IngenieroMecatronico/Firefighter/Firefighter_Plataforma/README.txt

OmniBotCC TRUE CLONE V3

Final refinements:
- PID gains matched to ESP-IDF firmware
- Static IP support added
- Full UDP compatibility
- Hardware mapping verified from schematic

Static IP:
192.168.50.171

UDP Commands:
start
stop
m0_rpm=150
m1_rpm=-120
m2_rpm=100
m3_rpm=-80
m0_dir=CW
m0_dir=CCW
