IngenieroMecatronico/Firefighter/STLs/Soporte_tambito.stl

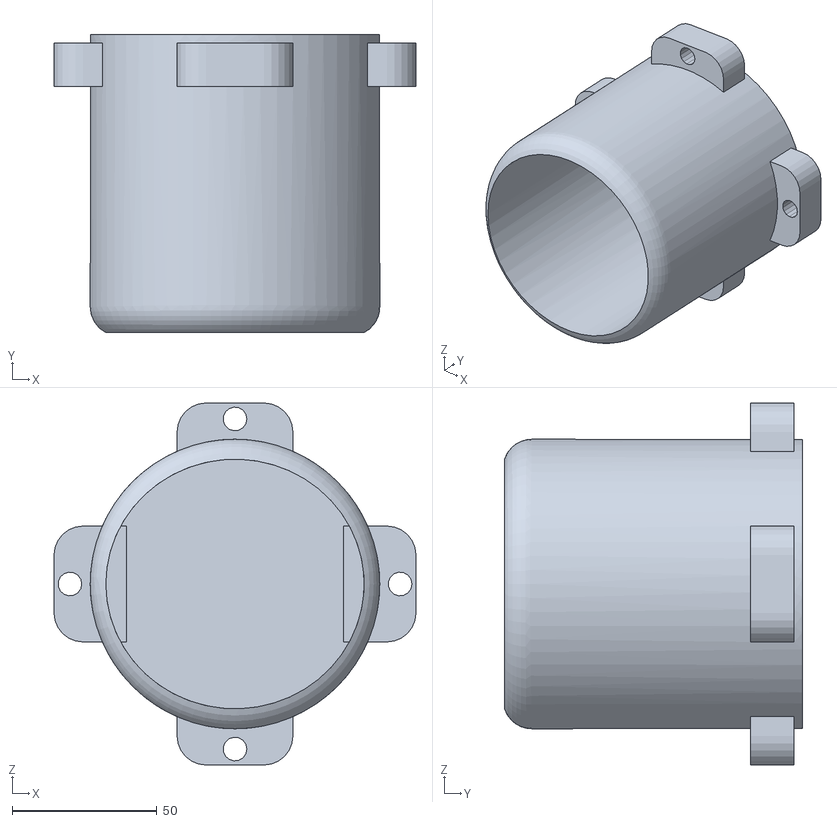
[picture p5: CAD file, 2026-10-28]
STLs/Soporte_tambito.stl
125.0 x 103.0 x 125.0
