IngenieroMecatronico/Firefighter/STLs/Tapadera_camara.stl

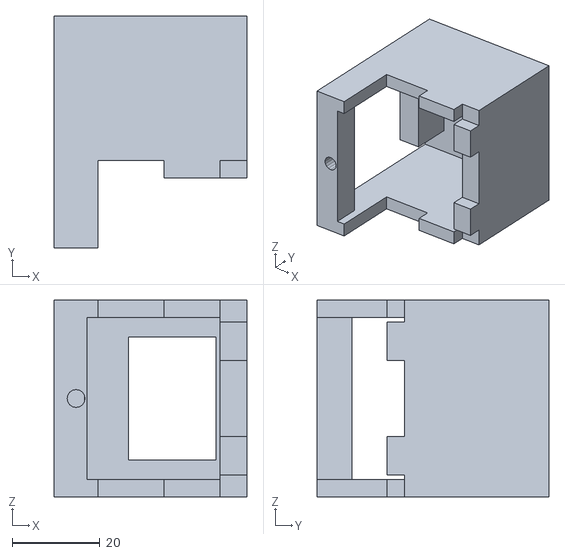
[picture p6: CAD file, 2026-10-28]
STLs/Tapadera_camara.stl
44.0 x 53.0 x 45.0
