IngenieroMecatronico/Firefighter/STLs/Roldanas_motoresv2.stl

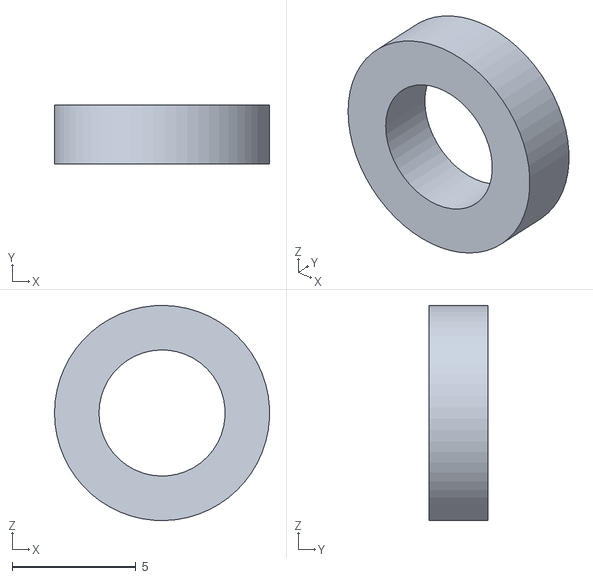
[picture p7: CAD file, 2026-10-28]
STLs/Roldanas_motoresv2.stl
8.69 x 2.40 x 8.70
