IngenieroMecatronico/Firefighter/STLs/Soporte_AS5600_R.stl

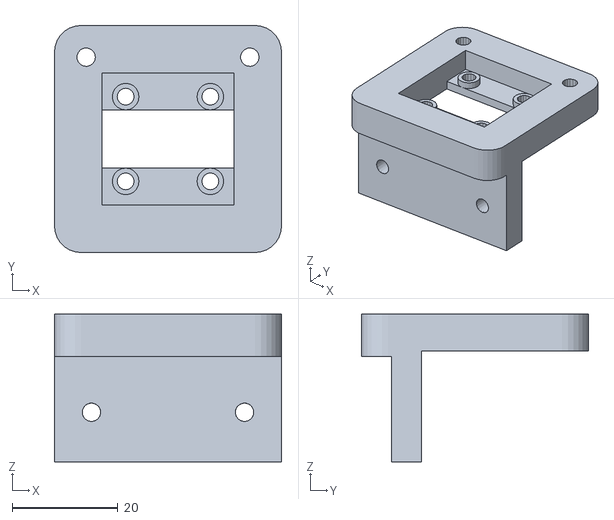
[picture p8: CAD file, 2026-10-28]
STLs/Soporte_AS5600_R.stl
43.0 x 43.0 x 28.0
