IngenieroMecatronico/Firefighter/STLs/Nivel 2 del Chasis v2.stl

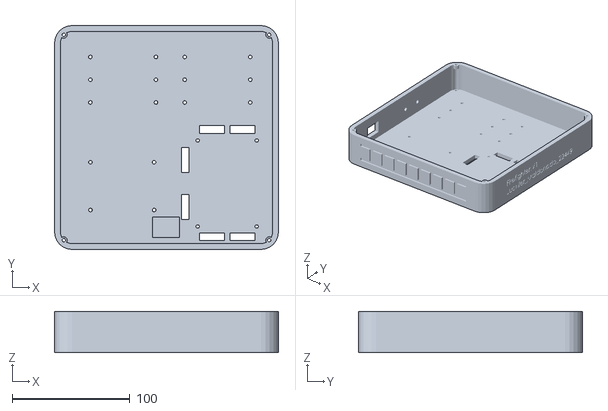
[picture p9: CAD file, 2026-10-28]
STLs/Nivel 2 del Chasis v2.stl
190.0 x 190.0 x 35.0
