IngenieroMecatronico/Firefighter/STLs/Tapadera_placa.stl

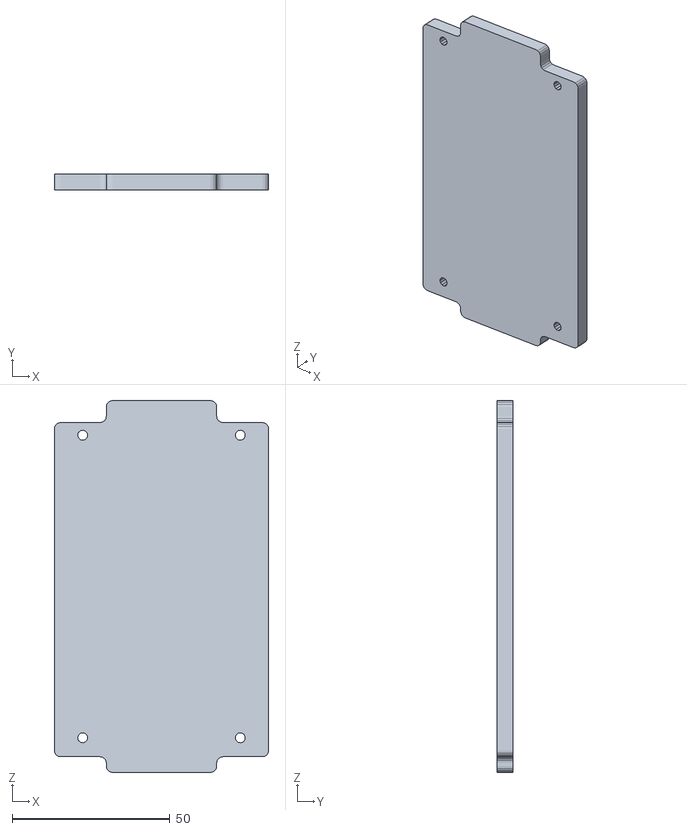
[picture p10: CAD file, 2026-10-28]
STLs/Tapadera_placa.stl
68.0 x 5.00 x 118.0
