IngenieroMecatronico/Firefighter/STLs/Efector_final_brazo.stl

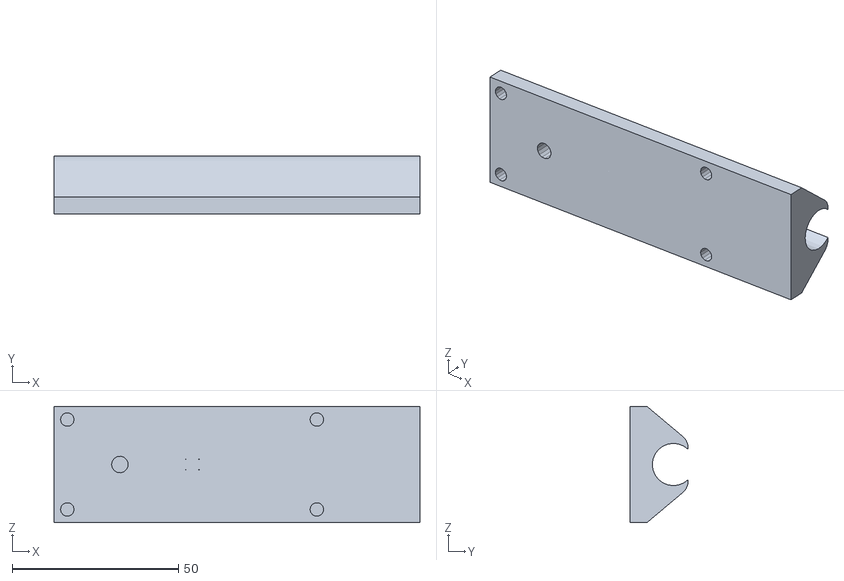
[picture p11: CAD file, 2026-10-28]
STLs/Efector_final_brazo.stl
110.0 x 17.3 x 35.0
