IngenieroMecatronico/Firefighter/STLs/Base_brazo.stl

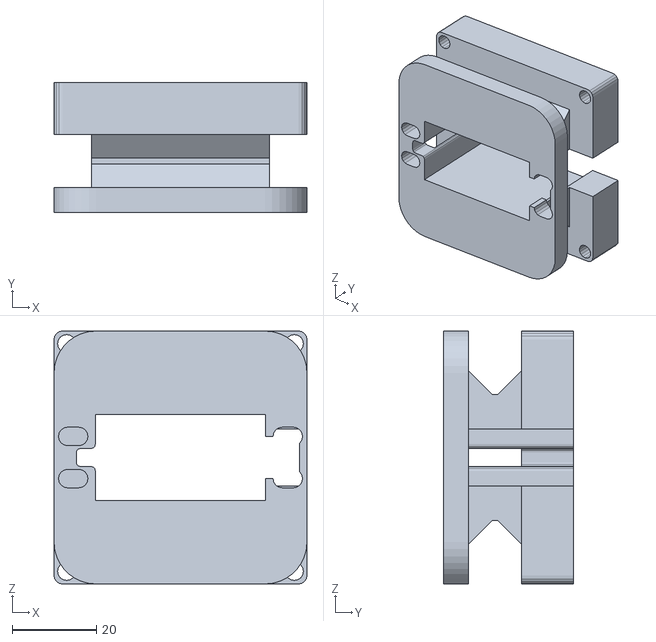
[picture p12: CAD file, 2026-10-28]
STLs/Base_brazo.stl
60.0 x 30.9 x 60.0
