IngenieroMecatronico/Firefighter/STLs/Brazo_direccionador.stl

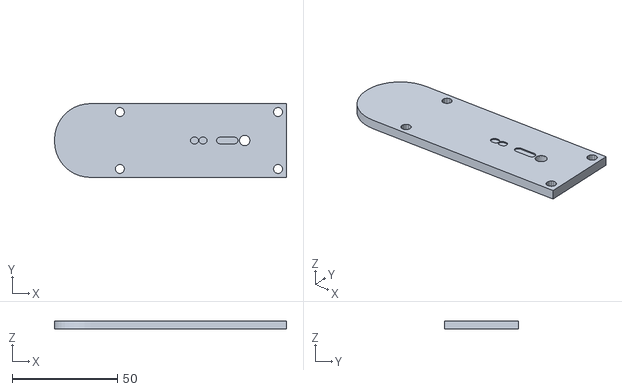
[picture p13: CAD file, 2026-10-28]
STLs/Brazo_direccionador.stl
110.0 x 35.0 x 4.00
