IngenieroMecatronico/Firefighter/STLs/Techo del Chasis v2.stl

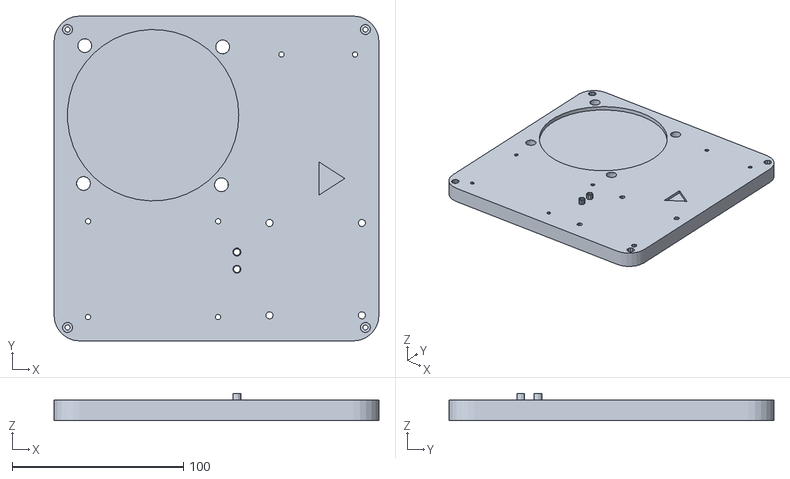
[picture p14: CAD file, 2026-10-28]
STLs/Techo del Chasis v2.stl
190.0 x 190.0 x 16.0
