IngenieroMecatronico/Firefighter/STLs/Escalera.stl

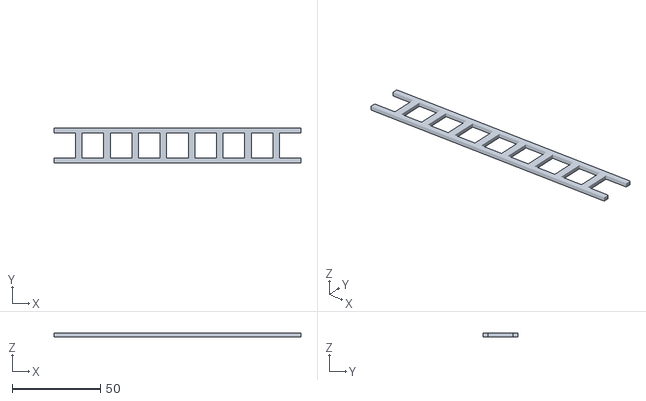
[picture p15: CAD file, 2026-10-28]
STLs/Escalera.stl
140.0 x 19.8 x 2.00
