IngenieroMecatronico/Firefighter/STLs/boquilla.stl

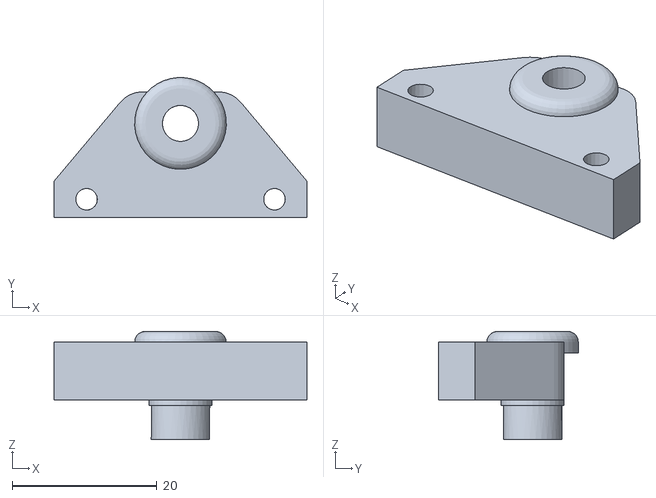
[picture p16: CAD file, 2026-10-28]
STLs/boquilla.stl
35.0 x 19.3 x 15.0
