IngenieroMecatronico/Firefighter/STLs/Eje_Amarillo v15.stl

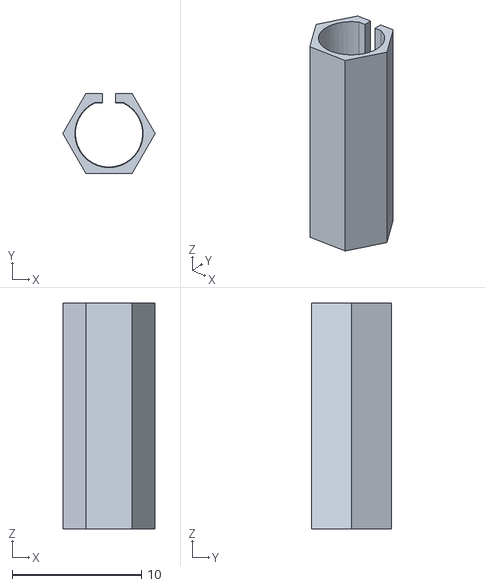
[picture p17: CAD file, 2026-10-28]
STLs/Eje_Amarillo v15.stl
7.16 x 6.20 x 17.5
