IngenieroMecatronico/Firefighter/STLs/Base_marcadores.stl

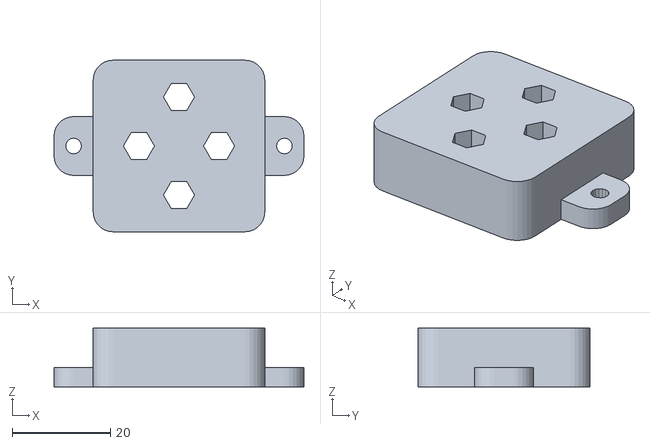
[picture p18: CAD file, 2026-10-28]
STLs/Base_marcadores.stl
51.0 x 35.0 x 12.0
