IngenieroMecatronico/Firefighter/STLs/Nivel 1 del Chasis v4.stl

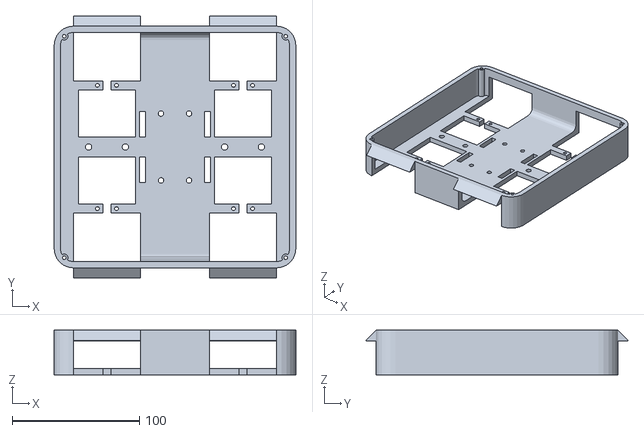
[picture p19: CAD file, 2026-10-28]
STLs/Nivel 1 del Chasis v4.stl
190.0 x 206.0 x 35.0
