IngenieroMecatronico/Firefighter/STLs/Abre_espacios.stl

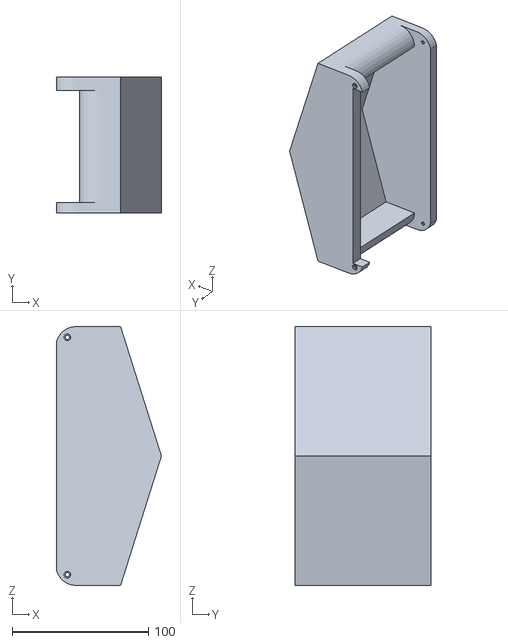
[picture p20: CAD file, 2026-10-28]
STLs/Abre_espacios.stl
77.0 x 100.0 x 190.0
