IngenieroMecatronico/Firefighter/STLs/Sujetador_esp32minitapadera.stl

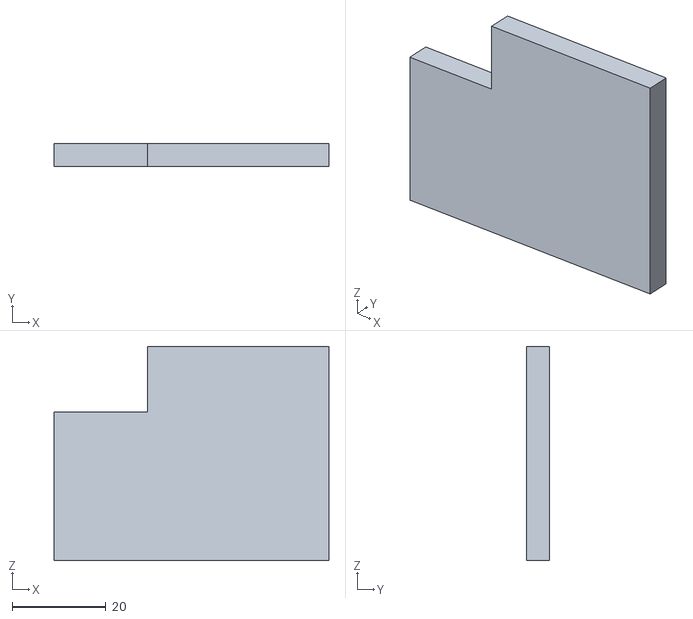
[picture p21: CAD file, 2026-10-28]
STLs/Sujetador_esp32minitapadera.stl
58.8 x 5.00 x 45.8
