IngenieroMecatronico/Firefighter/STLs/Brazo_servo_superior.stl

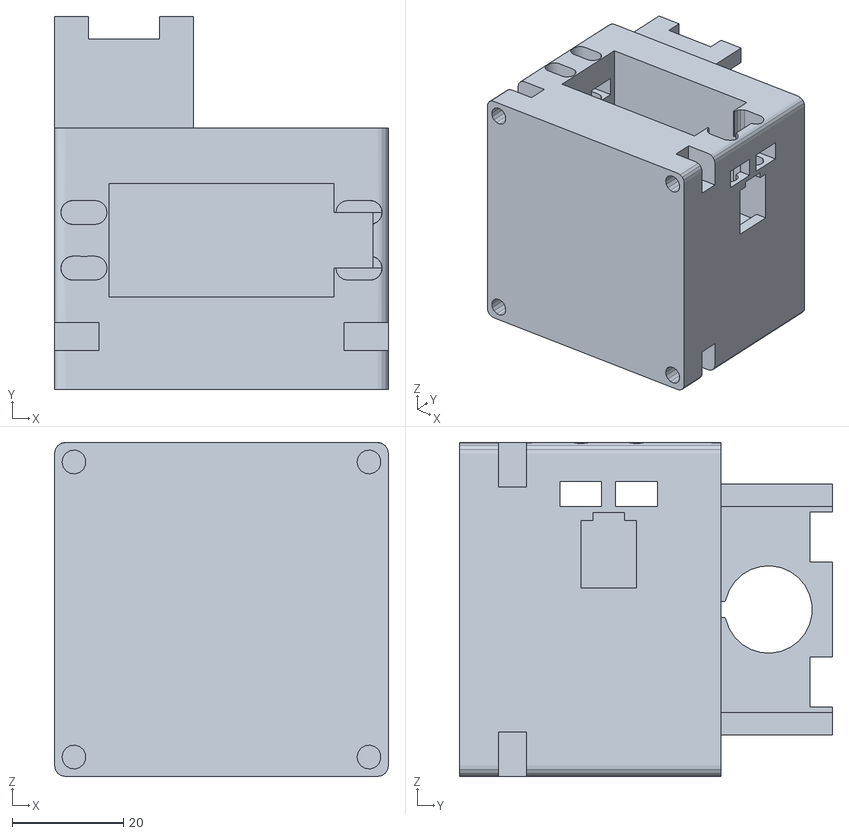
[picture p22: CAD file, 2026-10-28]
STLs/Brazo_servo_superior.stl
60.0 x 67.0 x 60.0
