IngenieroMecatronico/Firefighter/STLs/Sujetador_esp32mini.stl

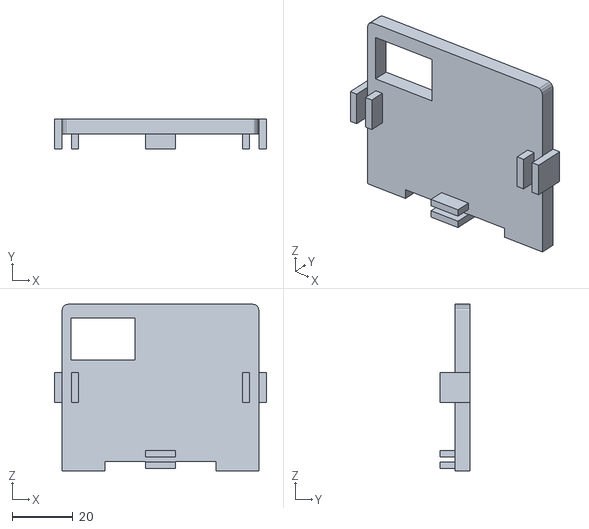
[picture p23: CAD file, 2026-10-28]
STLs/Sujetador_esp32mini.stl
70.0 x 10.0 x 55.0
