IngenieroMecatronico/Firefighter/STLs/Base Motor v15.stl

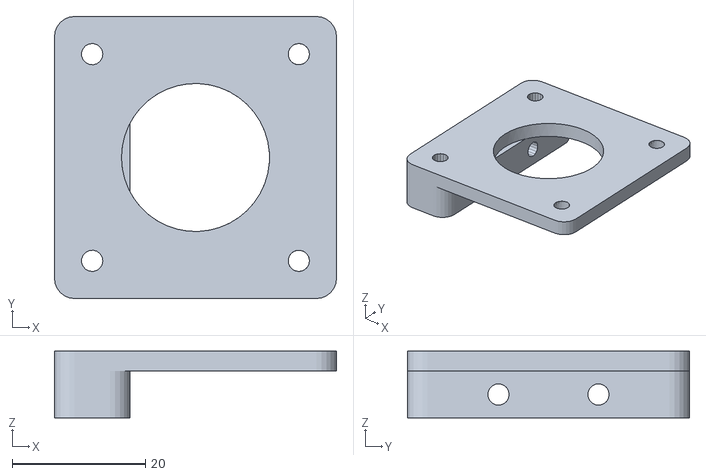
[picture p24: CAD file, 2026-10-28]
STLs/Base Motor v15.stl
42.3 x 42.3 x 10.0
