IngenieroMecatronico/Firefighter/STLs/Base_servomotor.stl

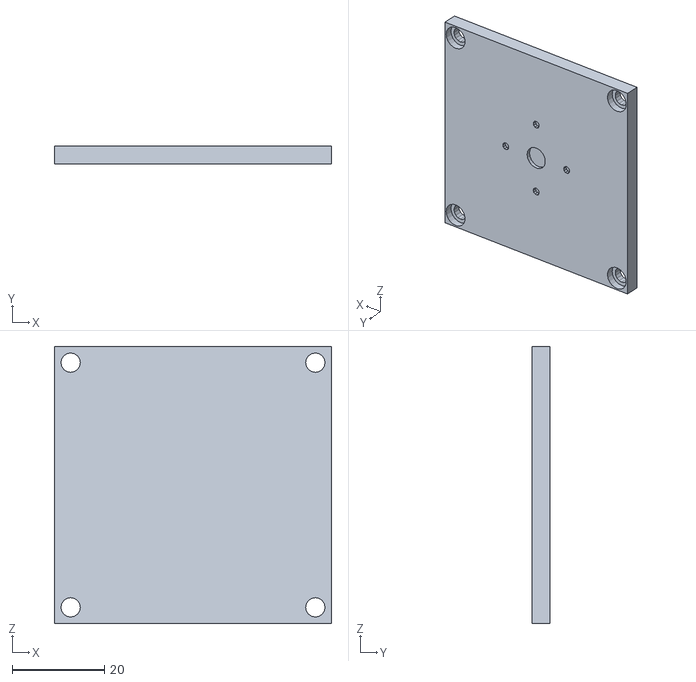
[picture p25: CAD file, 2026-10-28]
STLs/Base_servomotor.stl
60.0 x 4.00 x 60.0
