IngenieroMecatronico/Firefighter/STLs/Base_casa.stl

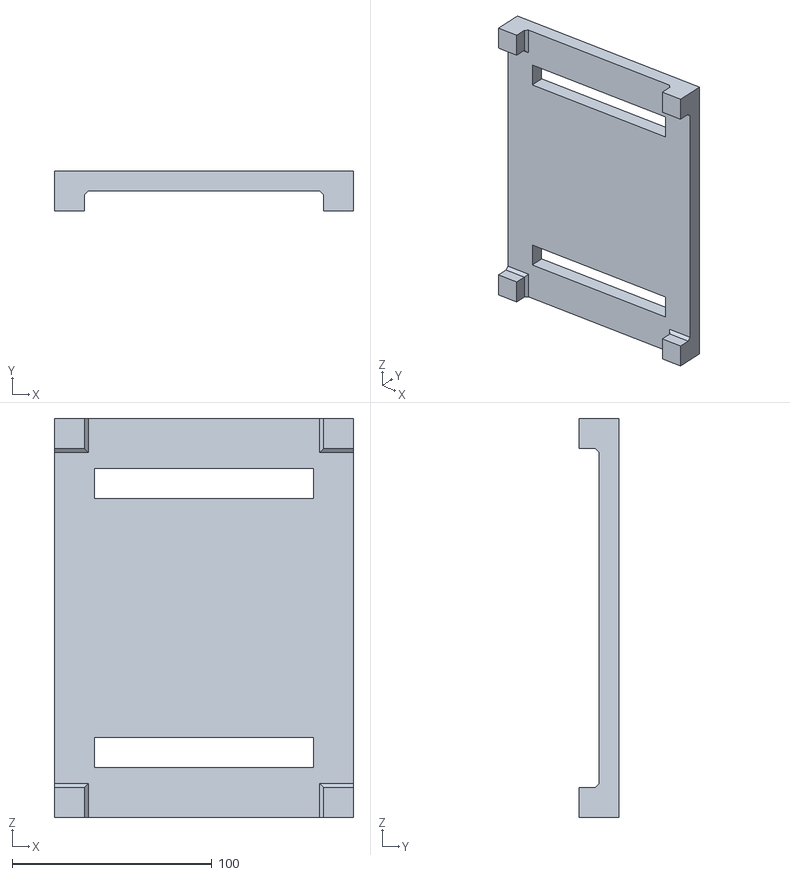
[picture p26: CAD file, 2026-10-28]
STLs/Base_casa.stl
150.0 x 20.0 x 200.0
