IngenieroMecatronico/Firefighter/STLs/Case_placa.stl

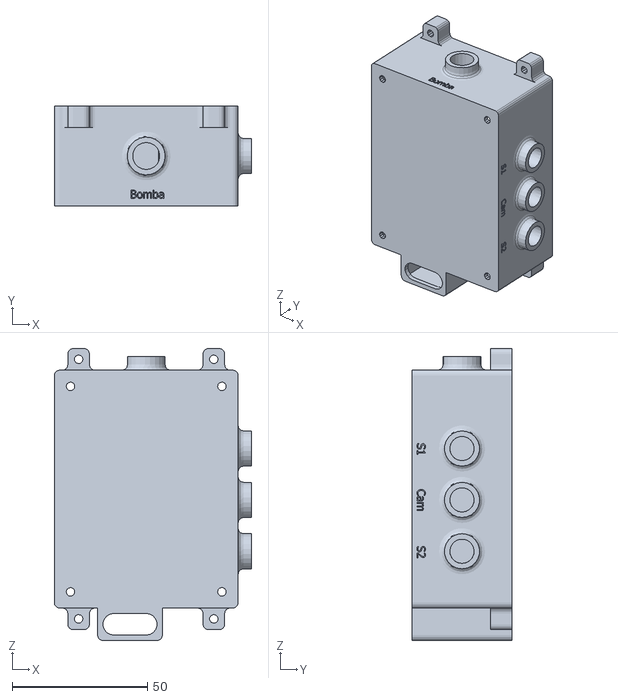
[picture p27: CAD file, 2026-10-28]
STLs/Case_placa.stl
73.0 x 37.0 x 108.0
