IngenieroMecatronico/Firefighter/STLs/Superior_casa.stl

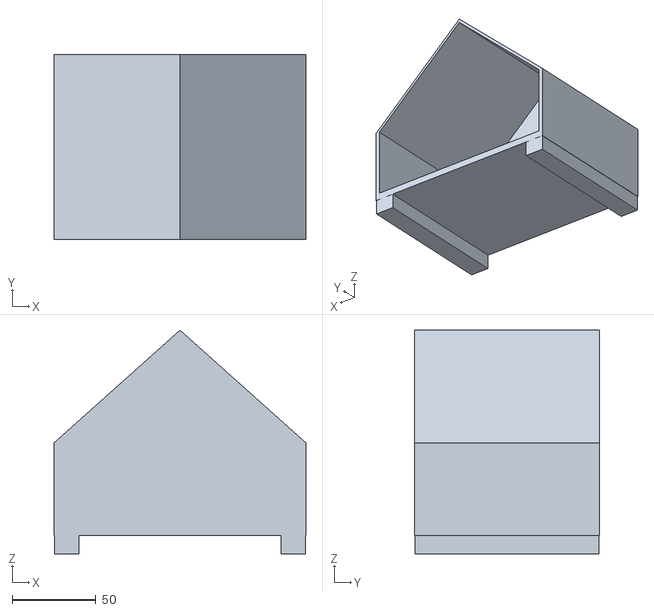
[picture p28: CAD file, 2026-10-28]
STLs/Superior_casa.stl
150.0 x 110.0 x 133.1
