IngenieroMecatronico/Firefighter/(list of files, cad)

Other CAD files:
STLs/Roldana_stepperv1.stl
STLs/boquilla2.stl
STLs/Soporte_AS5600_L.stl
